lillianletiecq/AutoCad-Intro/IMG_0468.jpeg

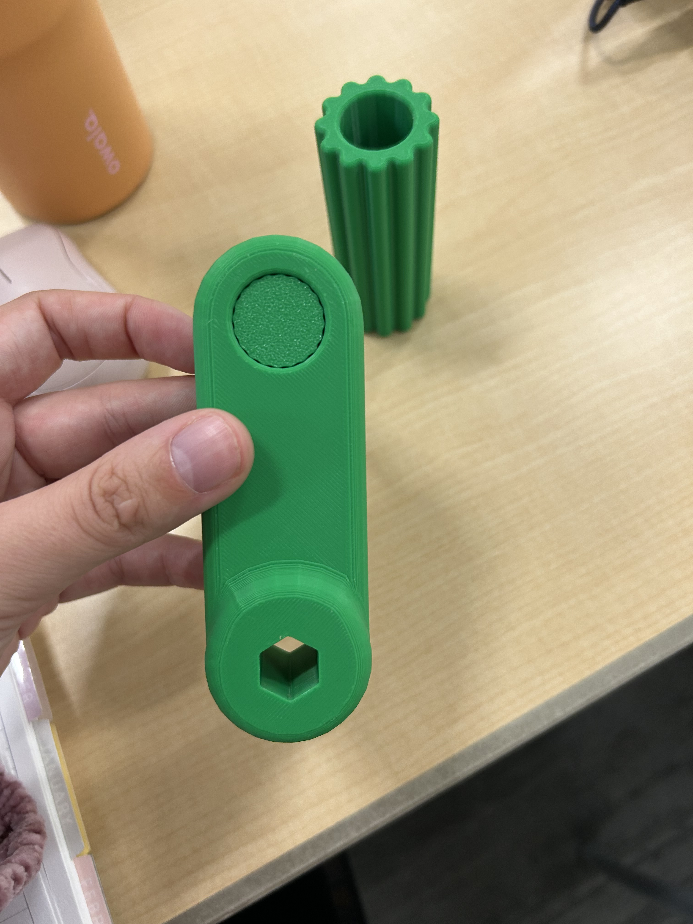
IMG_0468.jpeg
