lillianletiecq/AutoCad-Intro/IMG_0466.jpeg

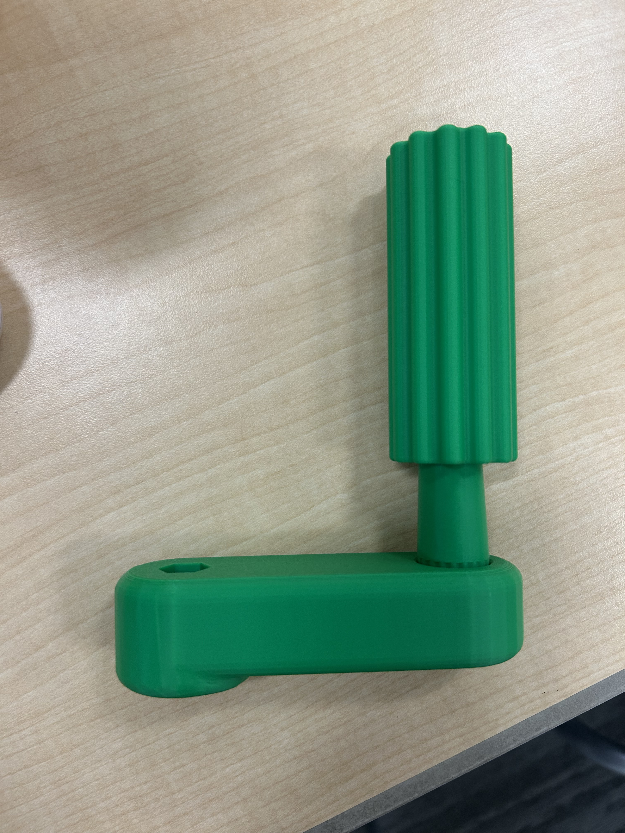
IMG_0466.jpeg
