lillianletiecq/AutoCad-Intro/IMG_0465.jpeg

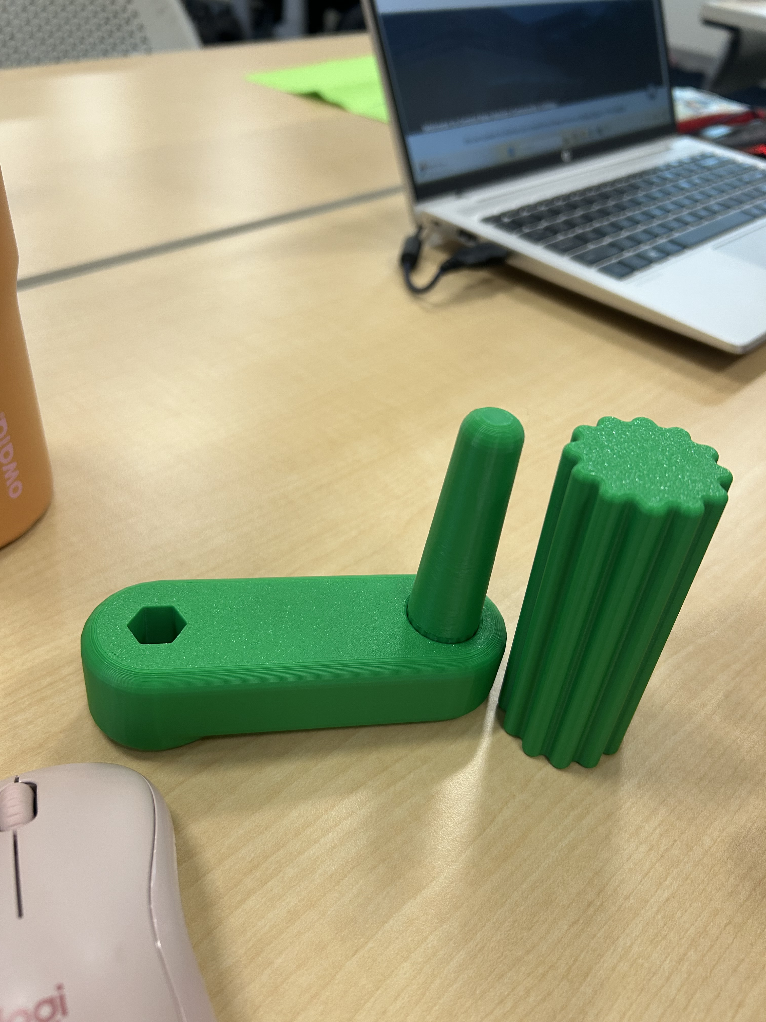
IMG_0465.jpeg
