lillianletiecq/AutoCad-Intro/wrenchAroni.2.stl

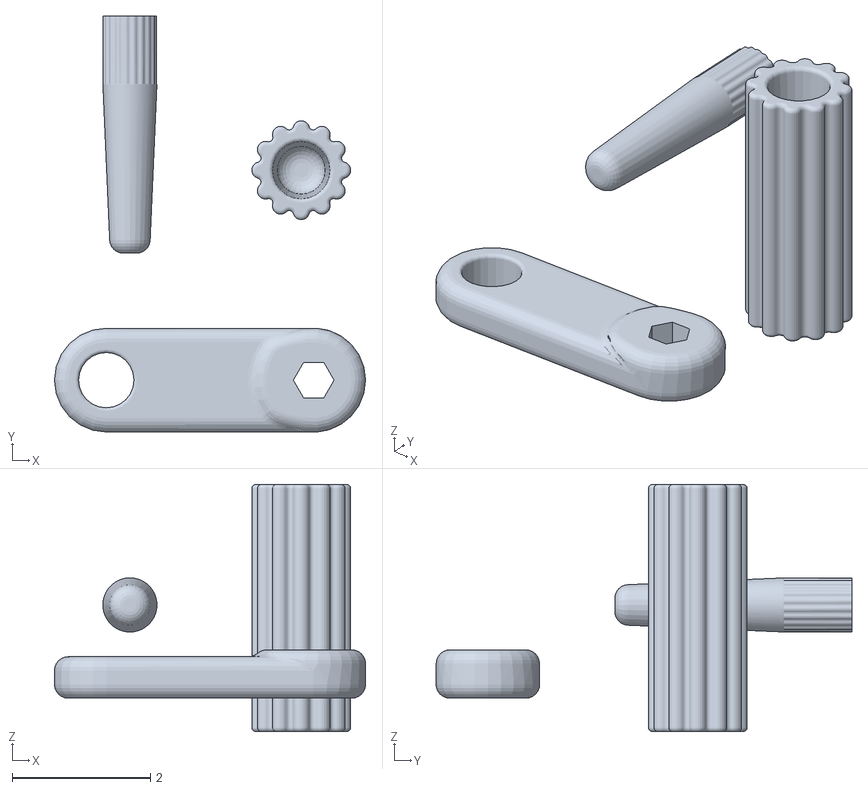
[picture p20: CAD file, 2026-10-07]
wrenchAroni.2.stl
4.50 x 6.02 x 3.58
