lillianletiecq/AutoCad-Intro/Wrench1.stl

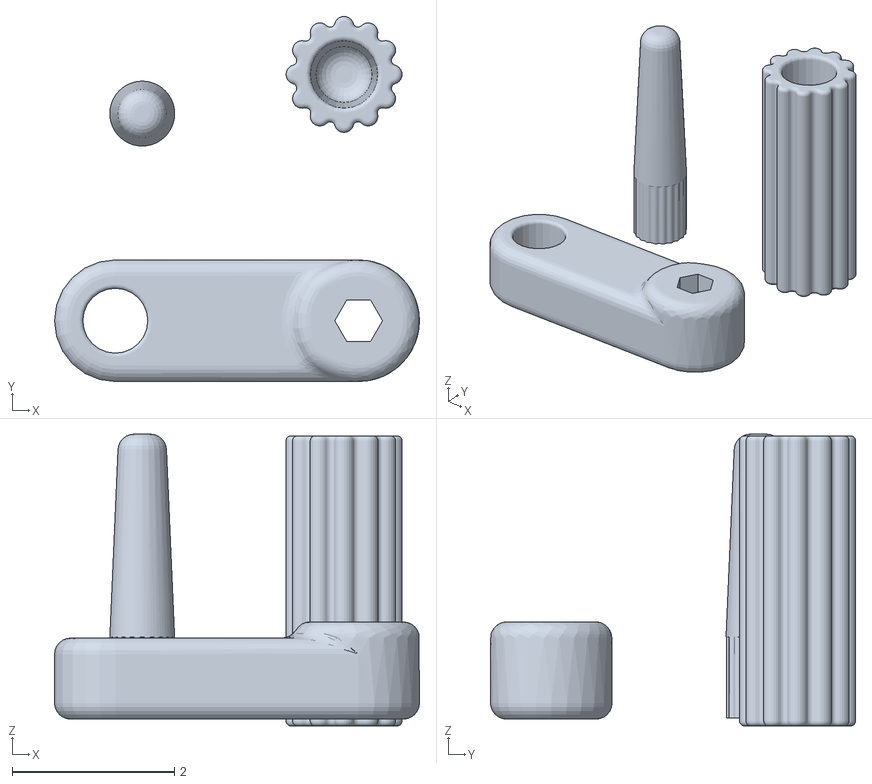
[picture p21: CAD file, 2026-09-29]
Wrench1.stl
4.50 x 4.50 x 3.60
