lillianletiecq/AutoCad-Intro/Drawing1.stl

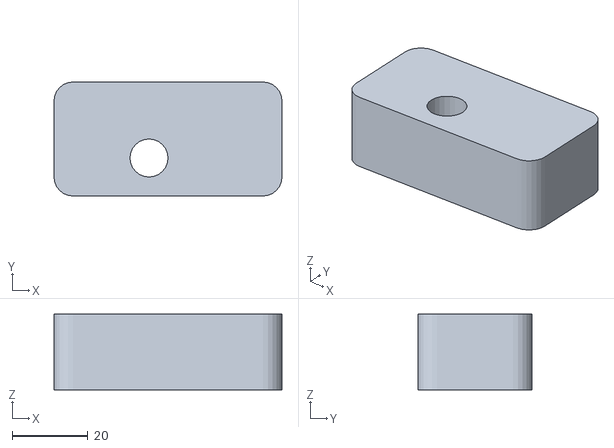
[picture p22: CAD file, 2026-09-16]
Drawing1.stl
60.0 x 30.0 x 20.0
