lillianletiecq/AutoCad-Intro/AutoPractice.stl

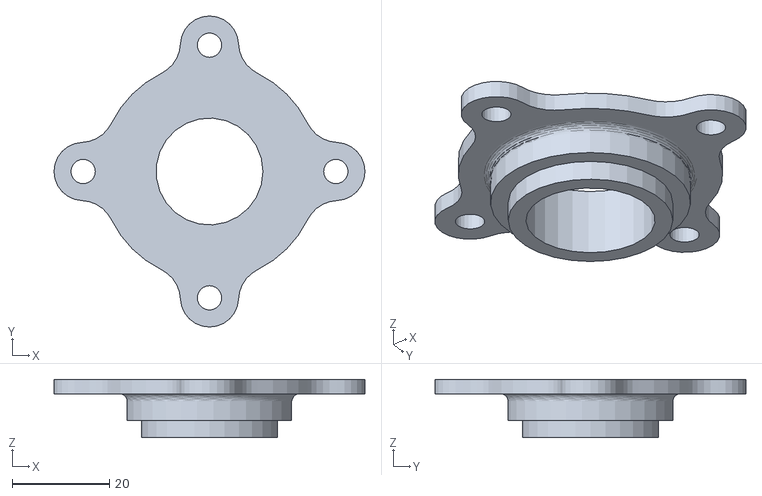
[picture p23: CAD file, 2026-09-16]
AutoPractice.stl
64.0 x 64.0 x 12.0
