lillianletiecq/AutoCad-Intro/Base1stDesign.pdf

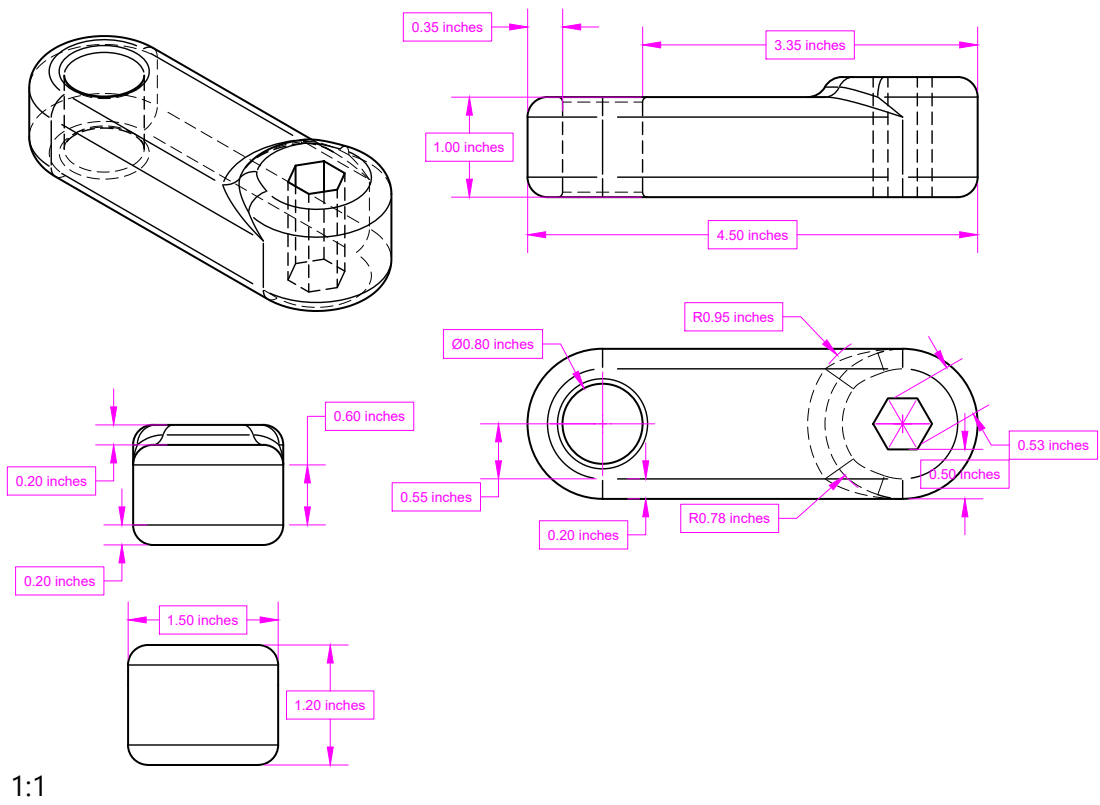
[picture p24: page 1]
1.00 inches; 4.50 inches; 0.53 inches Ø0.80 inches; 0.50 inches R0.95 inches R0.78 inches 0.35 inches; 3.35 inches 0.20 inches 0.20 inches; 0.55 inches 0.60 inches; 0.20 inches 1.50 inches; 1.20 inches 1:1
