lillianletiecq/AutoCad-Intro/Peg1stDesign.pdf

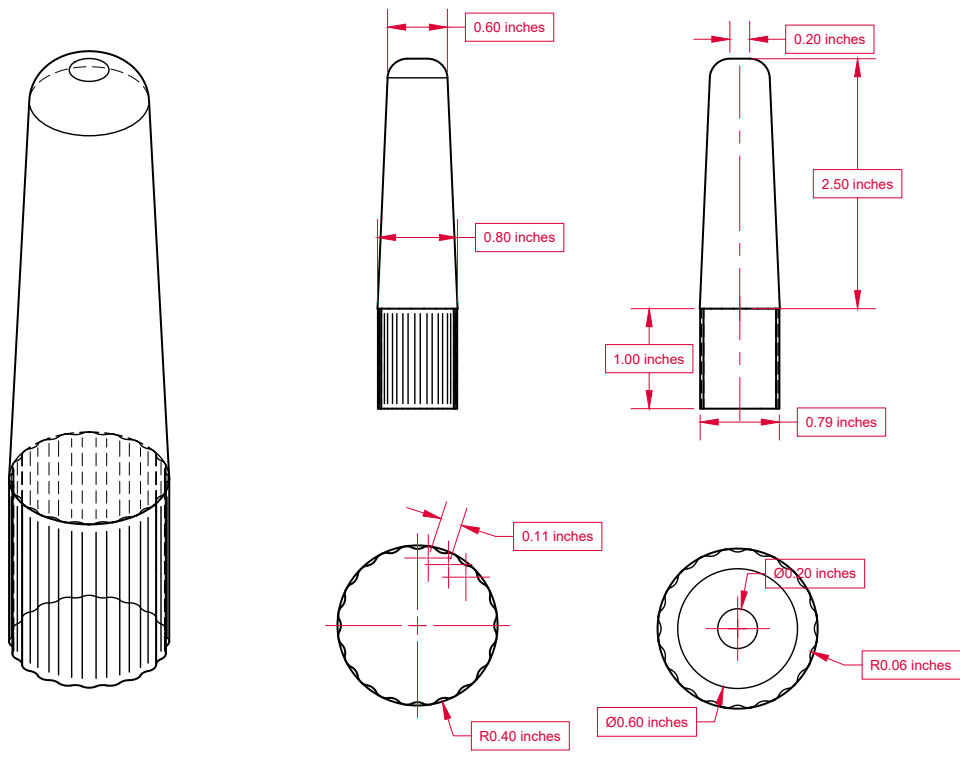
[picture p25: page 1]
0.60 inches 0.80 inches; 1.00 inches; 0.79 inches 0.11 inches R0.40 inches; Ø0.20 inches Ø0.60 inches; R0.06 inches 0.20 inches 2.50 inches
