lillianletiecq/AutoCad-Intro/Base_Wrench.pdf

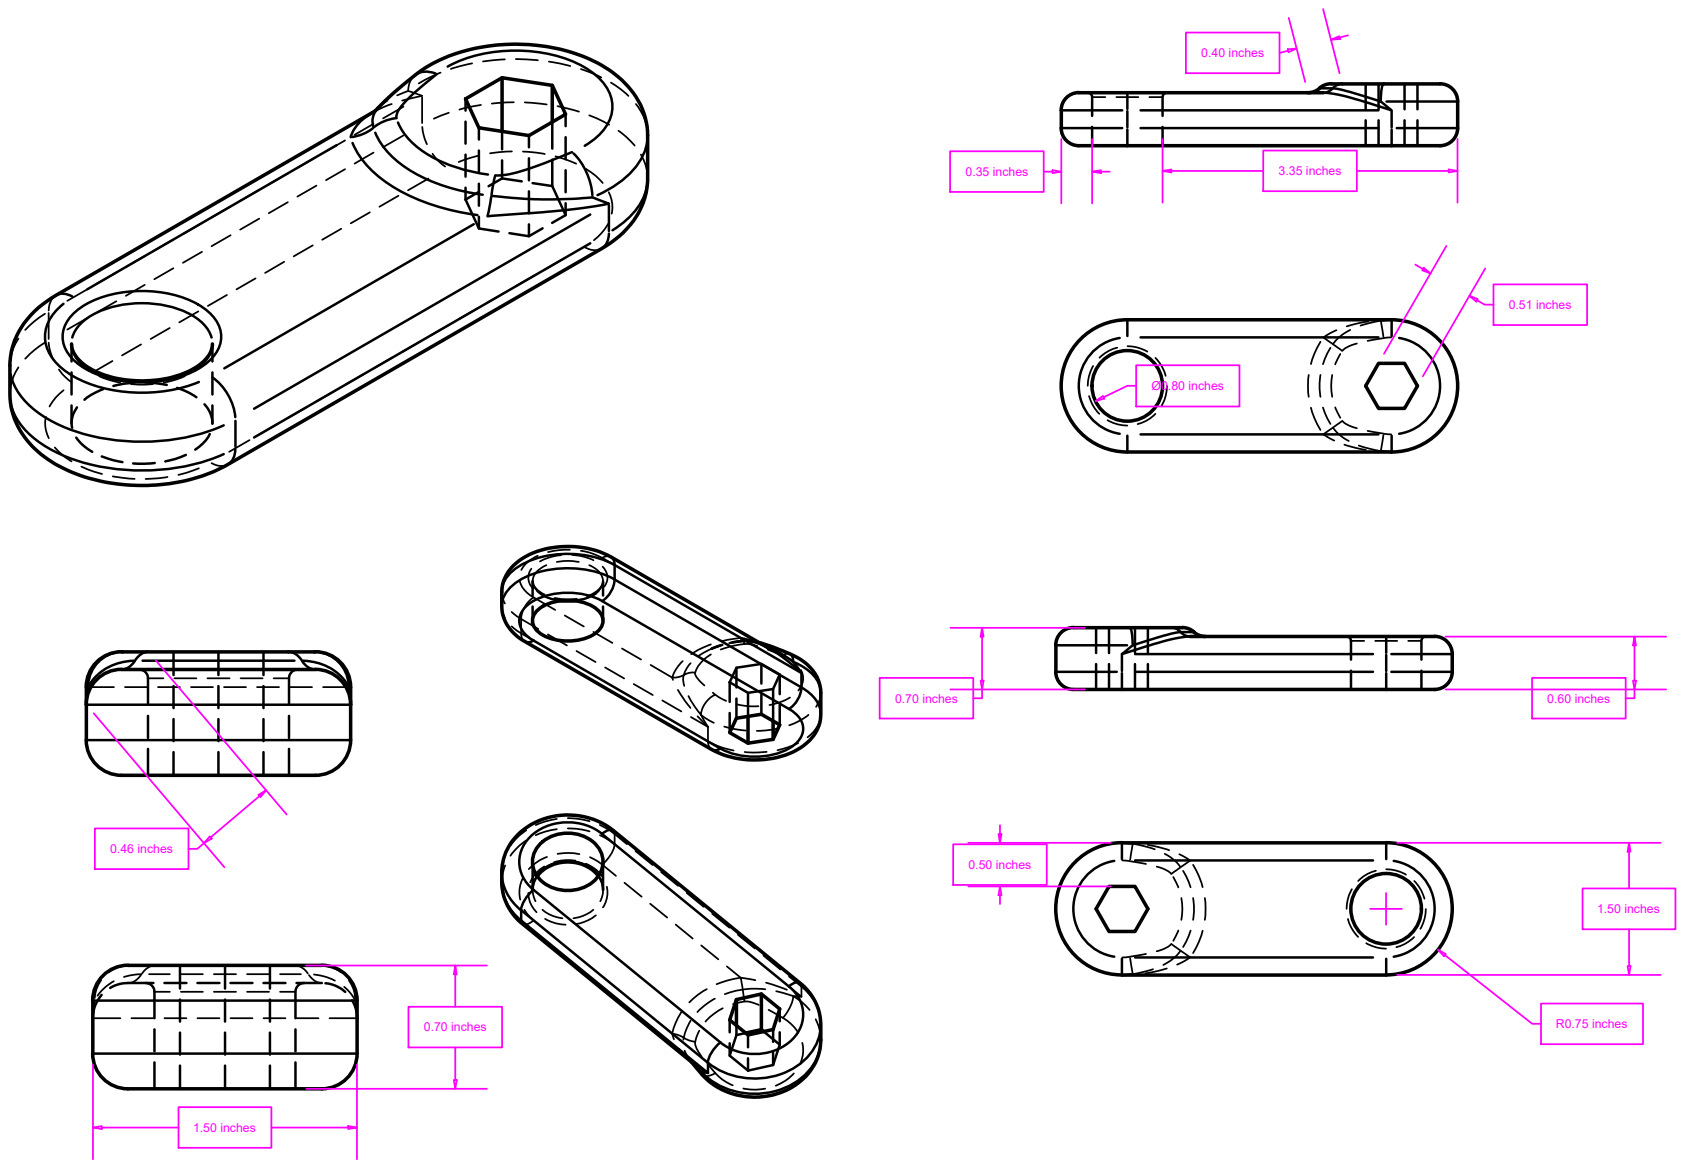
[picture p26: page 1]
1.50 inches; 1.50 inches 0.70 inches; 0.60 inches 0.70 inches 0.46 inches; Ø0.80 inches; 0.51 inches 0.35 inches; 3.35 inches 0.40 inches 0.50 inches; R0.75 inches
