lillianletiecq/AutoCad-Intro/Handle_Wrench.pdf

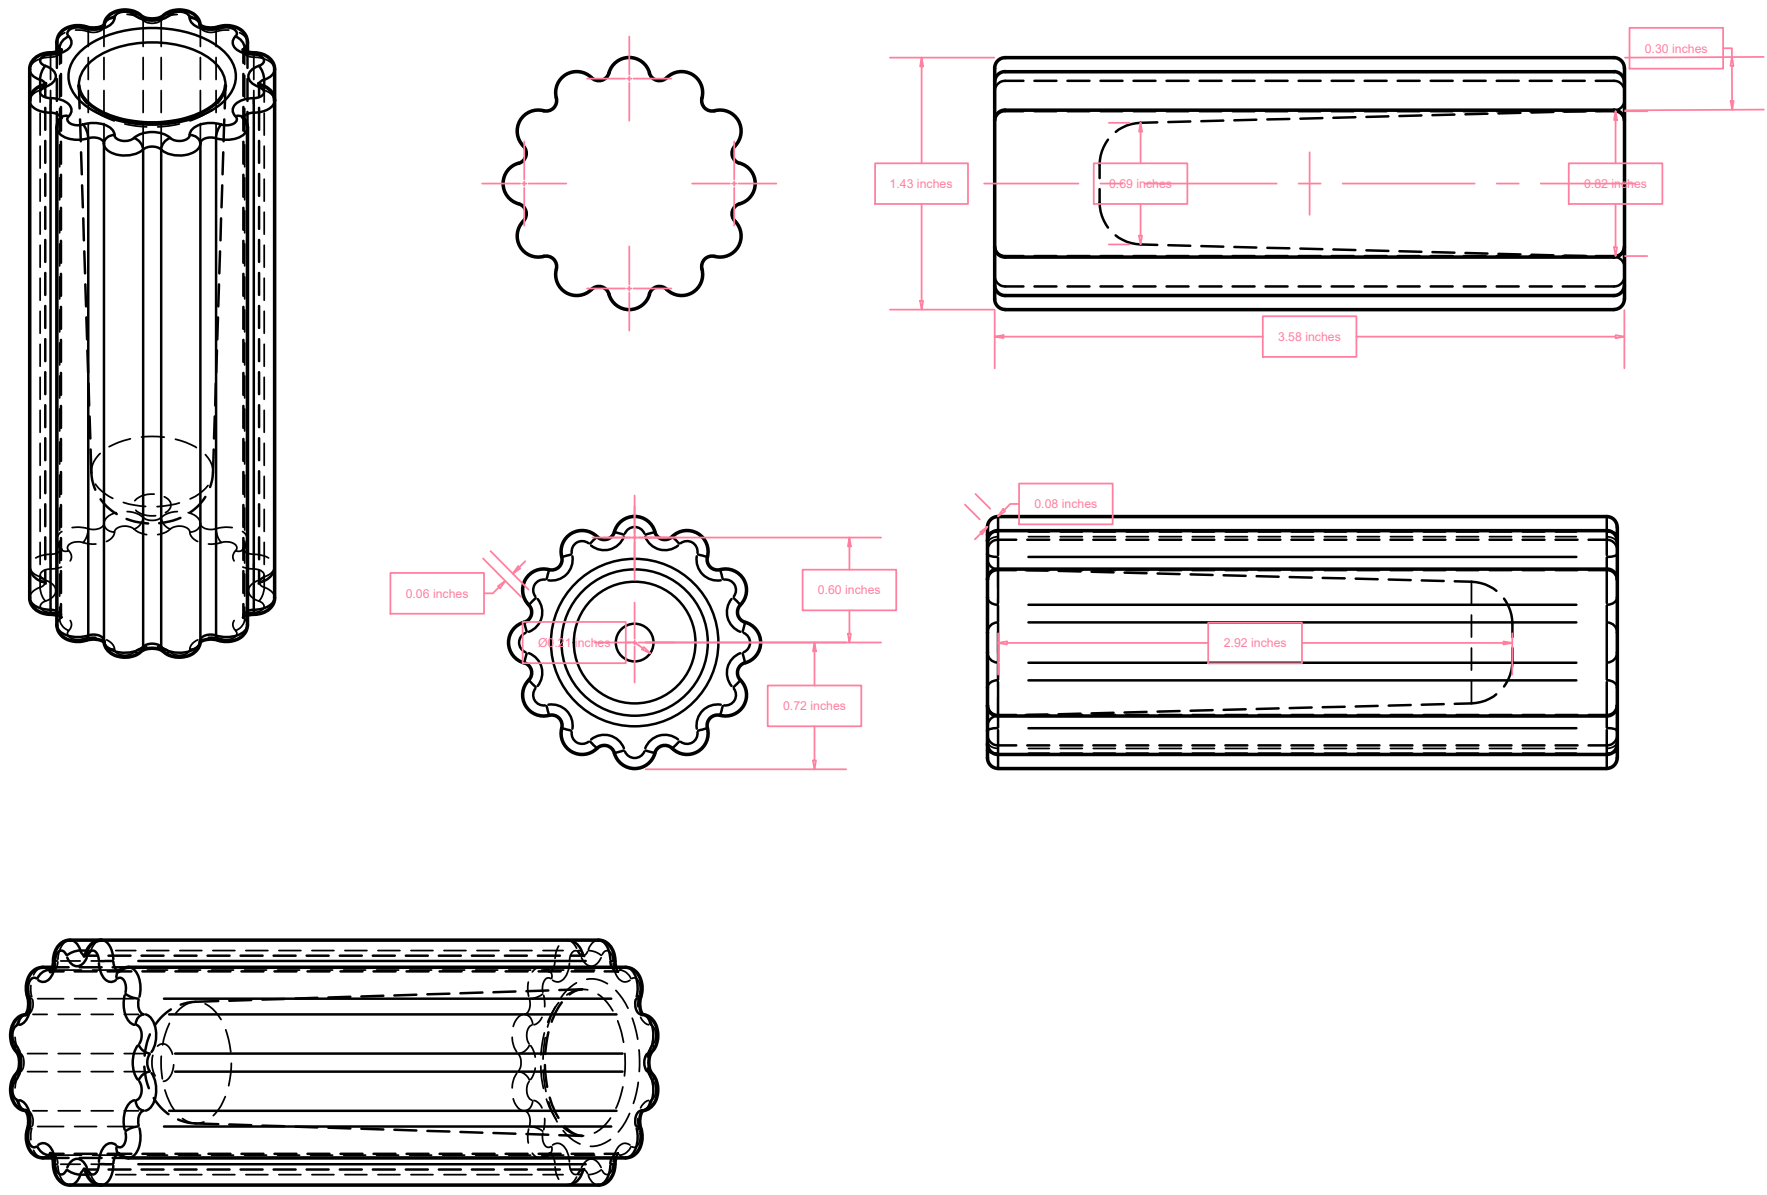
[picture p27: page 1]
1.43 inches; 0.30 inches 0.69 inches; 0.82 inches 0.08 inches; 2.92 inches3.58 inches Ø0.21 inches; 0.60 inches 0.72 inches 0.06 inches
