lillianletiecq/AutoCad-Intro/Peg_Wrench.pdf

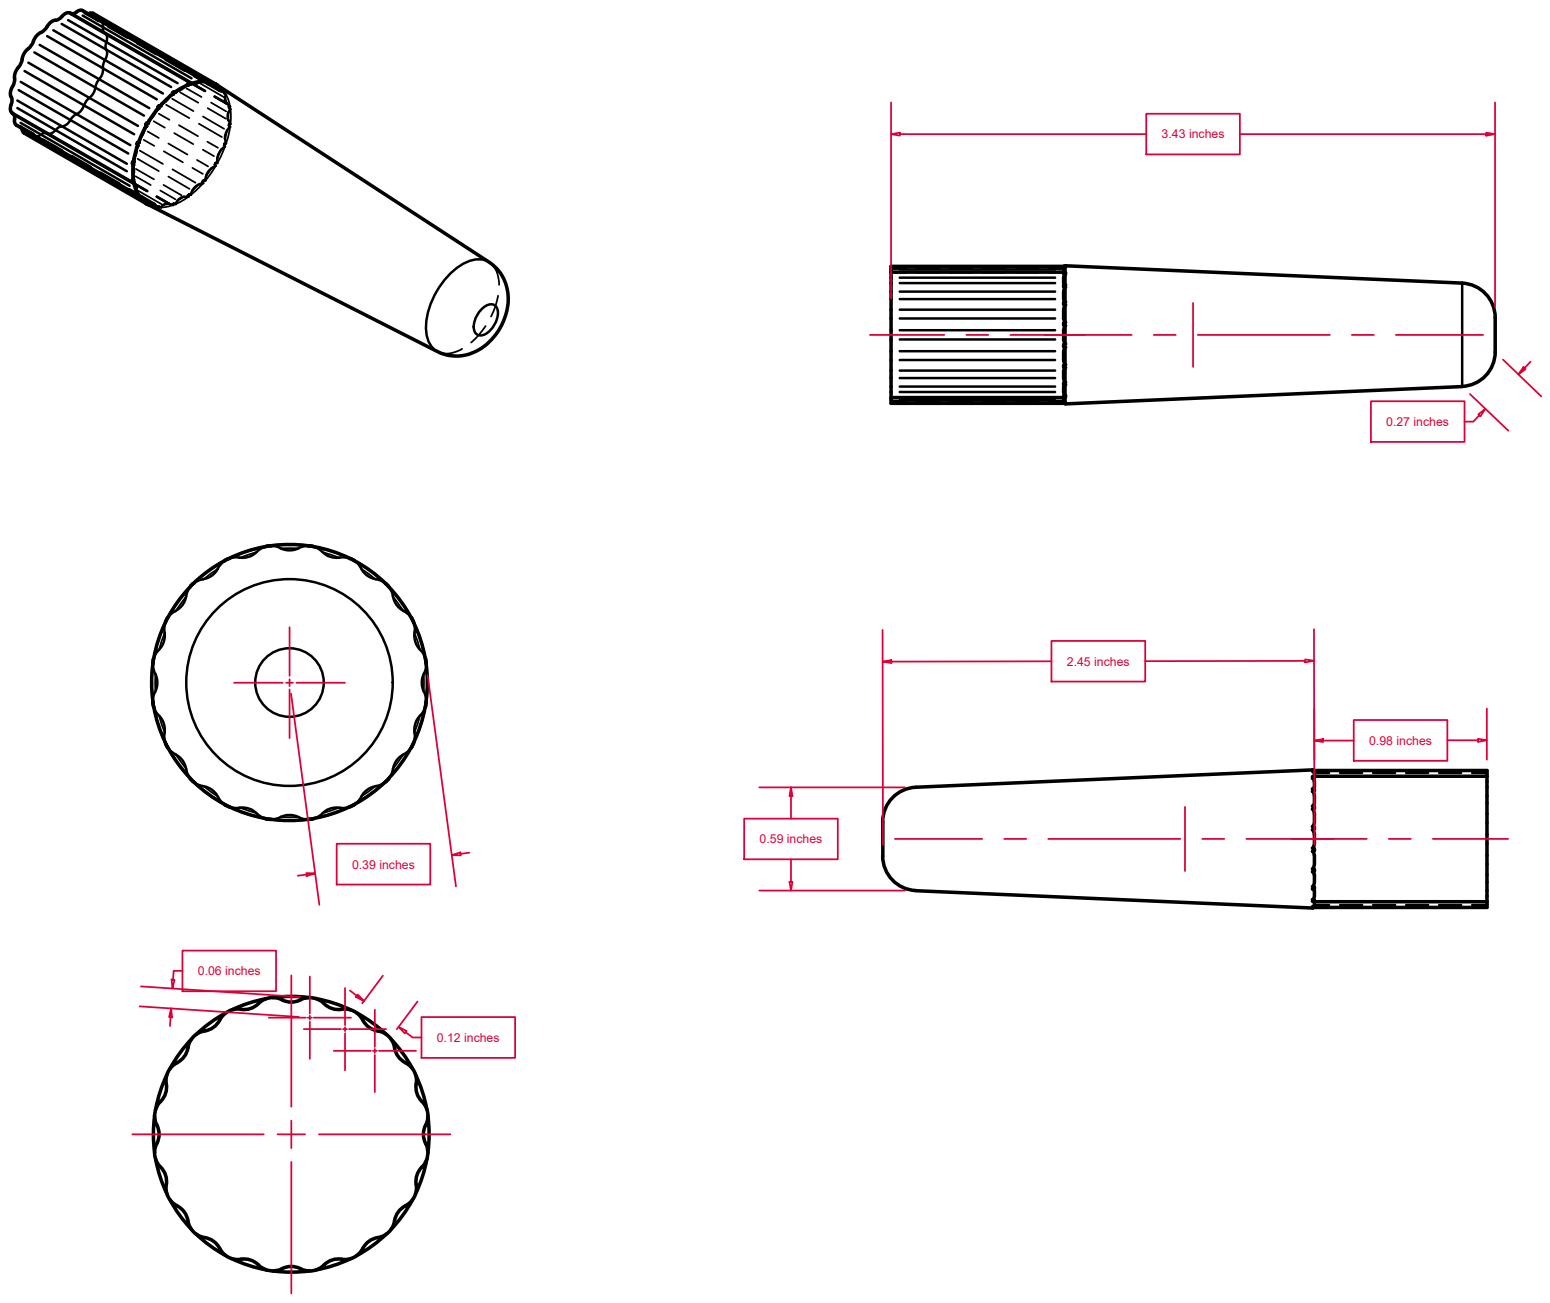
[picture p28: page 1]
0.59 inches; 2.45 inches; 0.98 inches 0.39 inches 0.06 inches; 0.27 inches 0.12 inches; 3.43 inches
