lillianletiecq/AutoCad-Intro/(commit log)

2026-09-16 Guided assignment
    2nd project created
    [AutoPractice.stl]
2026-09-16 1st AutoCad Project!
    [Drawing1.stl]
2026-09-29 Kids wrench design for first 3D print test
    Yay
    [Wrench1.stl]
2026-09-30 Photos of first print
    20% infill, triangle pattern. Photos taken before testing
2026-10-07 Final Design of Kid's wrench
    Optimized to keep print time and material usage down
